antmicro/ddr5-testbed/README.md

# DDR5 Testbed

Copyright (c) 2022-2023 [Antmicro](https://www.antmicro.com)

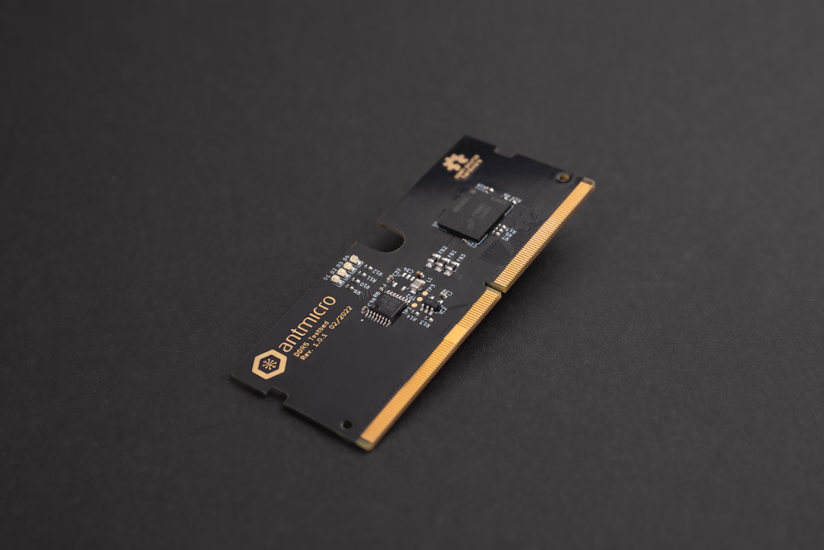
[picture p1: img/ddr5-testbed.png]


## Overview

This project contains open hardware design files for an experimental test module in the mechanical form factor of SO-DIMM.
The module includes a single DDR5 RAM IC with all signals break-routed in the SO-DIMM edge connector.
The board has been designed to target Micron [MT60B2G8HB-48B:A](https://media-www.micron.com/-/media/client/global/documents/products/data-sheet/dram/ddr5/16gb_ddr5_sdram_diereva.pdf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)
16Gb DRAM.
The design files were prepared in KiCad.
Please note that this board is not electrically compatible with off-the-shelf SO-DIMM DDR memory modules.
It is compatible with [this](https://github.com/antmicro/lpddr4-test-board) experimental testing platform.

### Project structure

The main project directory contains KiCad PCB project files, a LICENSE and a README.
The remaining files are stored in the following directories:

* `lib` - contains the component libraries
* `img` - contains graphics for this README
* `doc` - contains schematics in PDF form
* `assets` - contains visual assets for showcasing this design on [Open Hardware Portal](https://openhardware.antmicro.com).

## License

This project is published under the [Apache-2.0](LICENSE) license.
