antmicro/ddr5-testbed/assets/previews/layer0.png

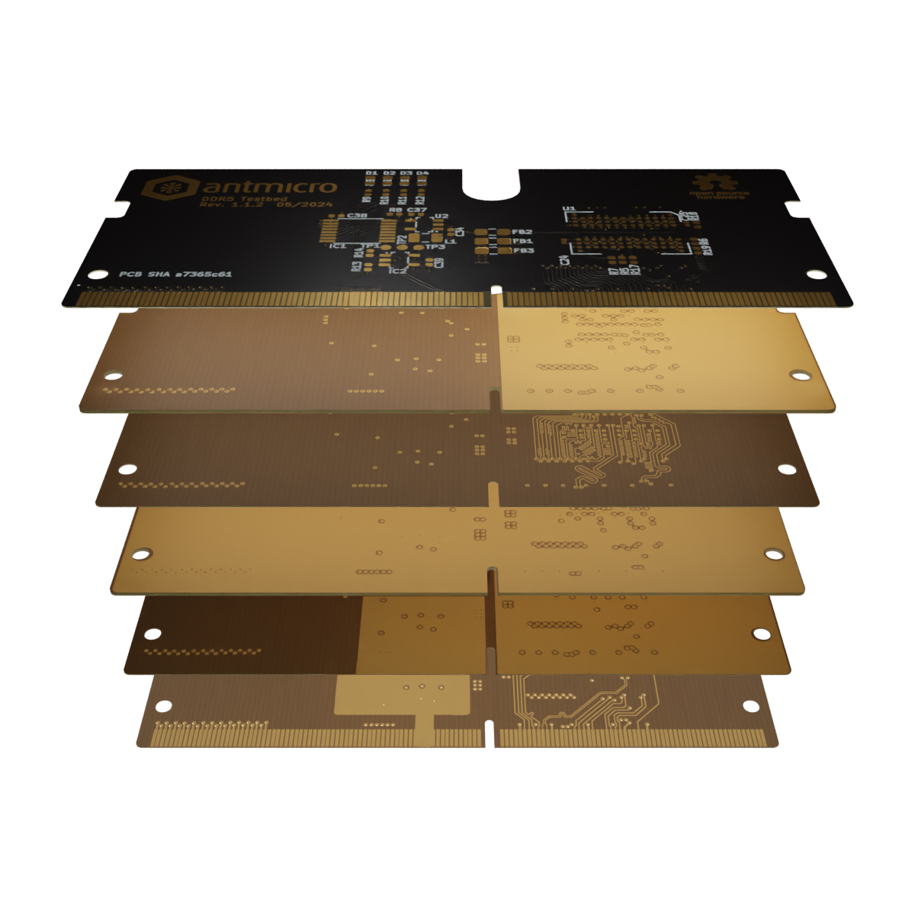
assets/previews/layer0.png
