antmicro/ddr5-testbed/assets/previews/layer3.png

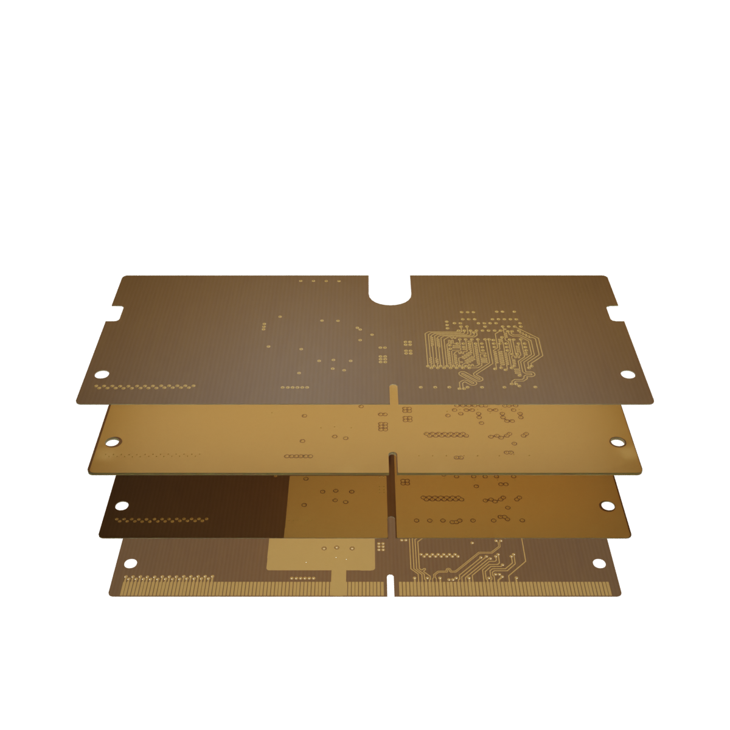
assets/previews/layer3.png
