antmicro/ddr5-testbed/assets/previews/leftT.png

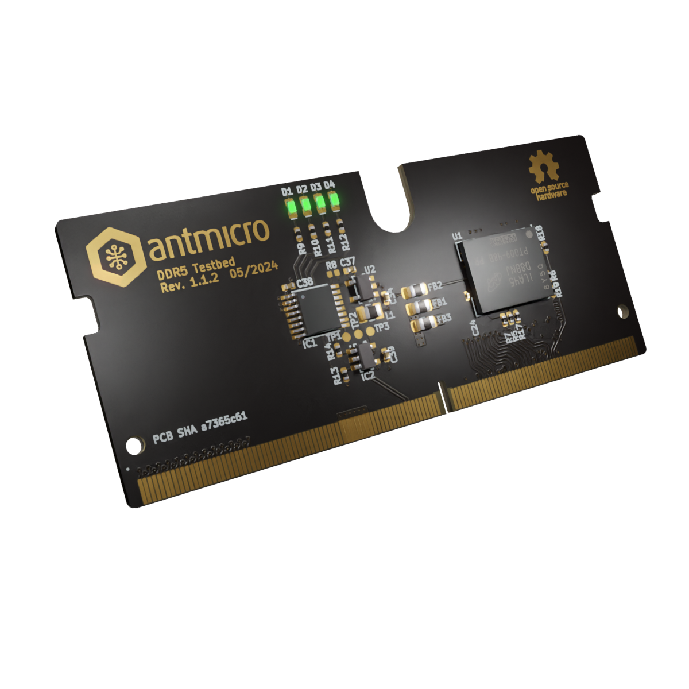
assets/previews/leftT.png
