antmicro/ddr5-testbed/assets/previews/rightT.png

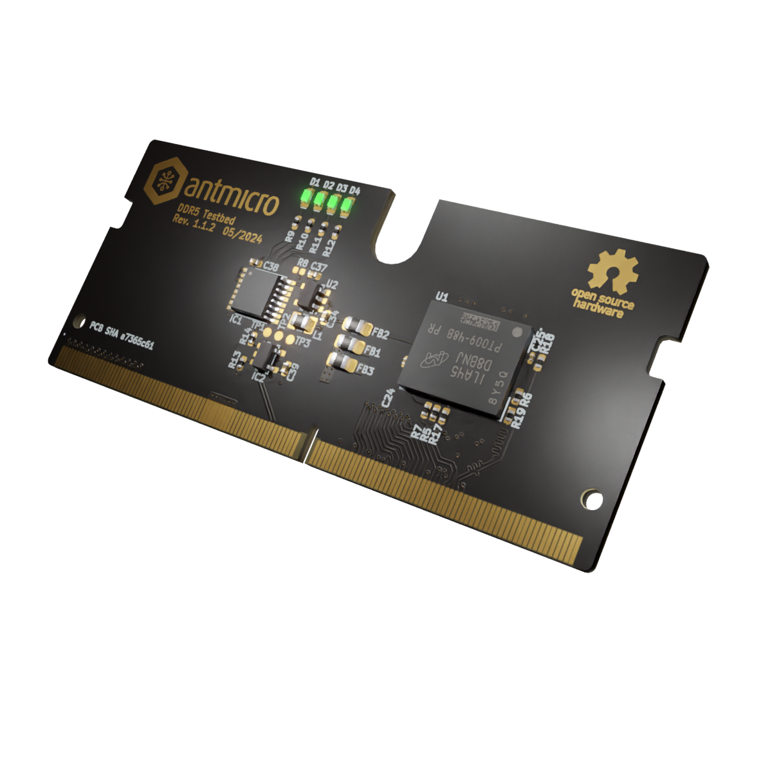
assets/previews/rightT.png
