antmicro/ddr5-testbed/doc/ddr5-testbed.pdf

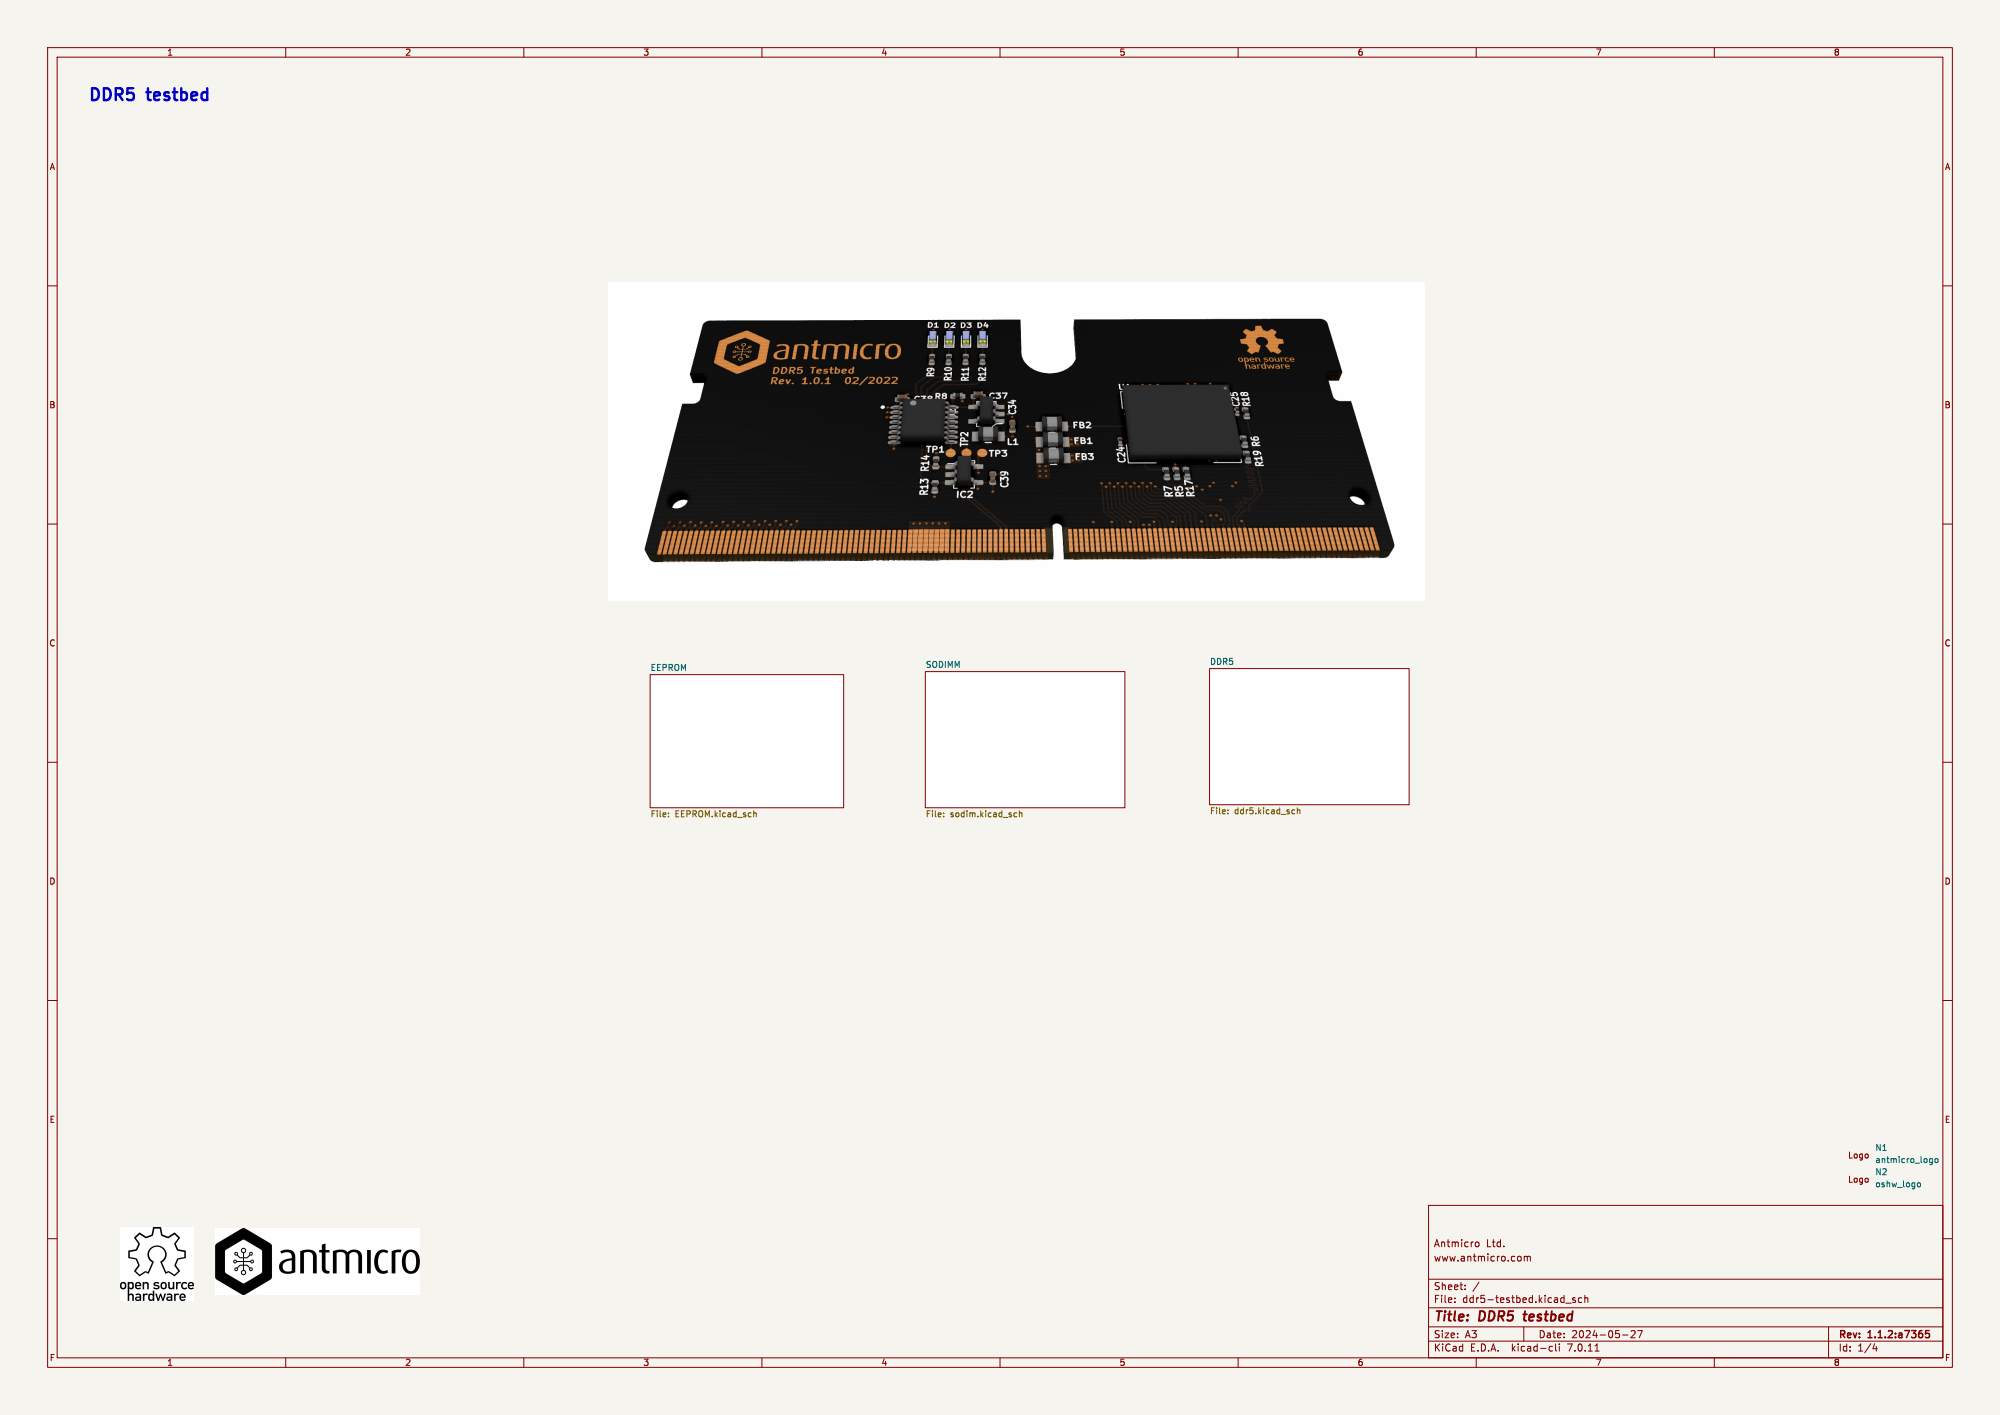
[picture p12: page 1]

File: ddr5-testbed.kicad_sch Sheet: / www.antmicro.com

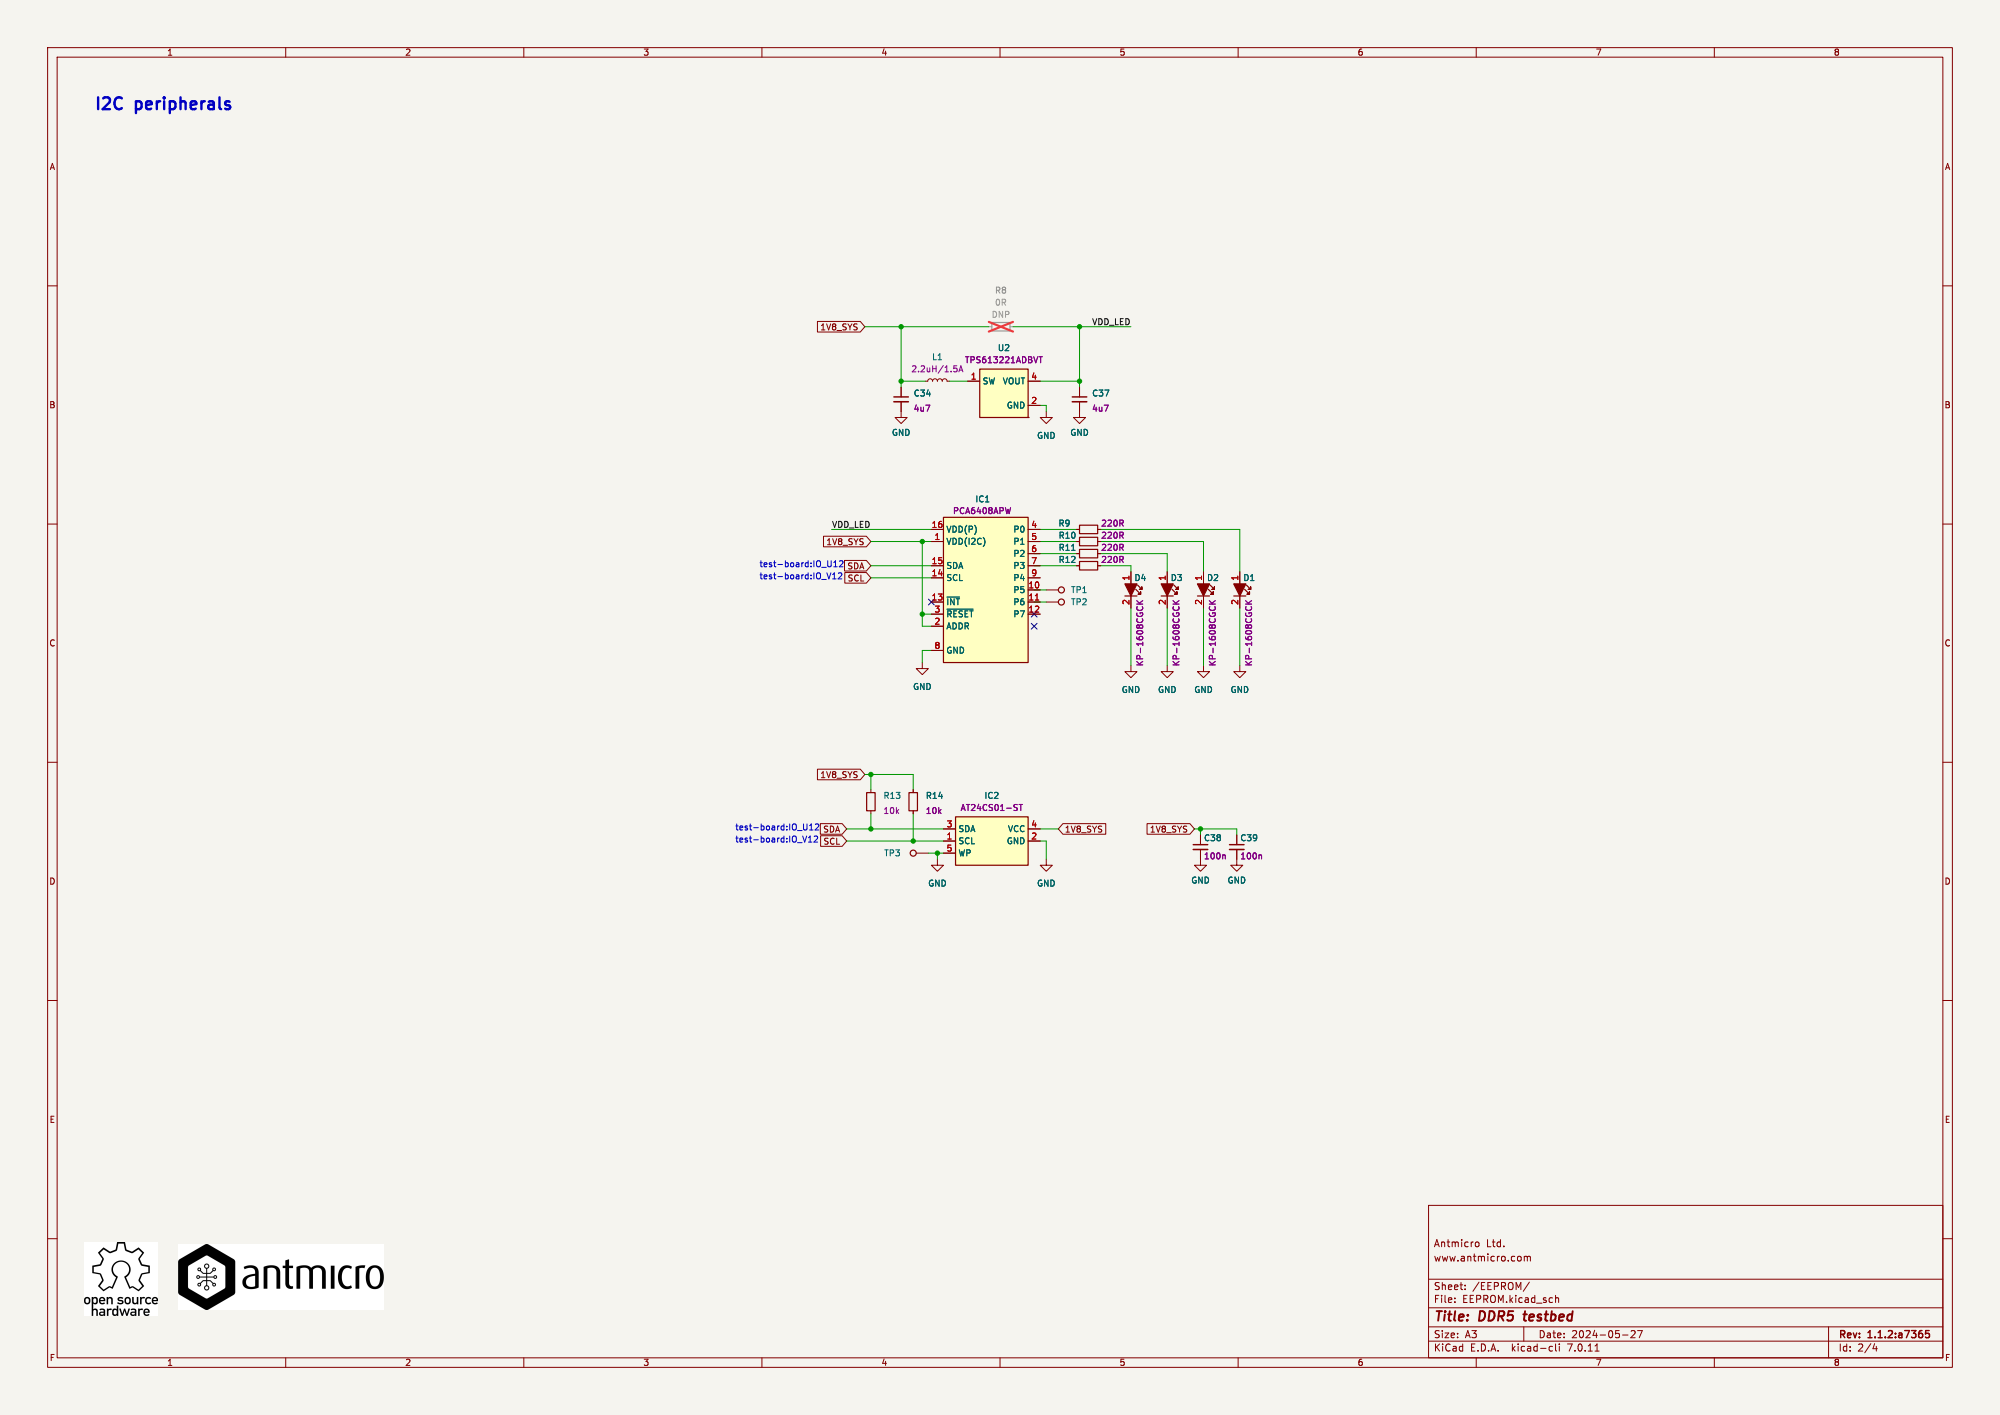
[picture p13: page 2]

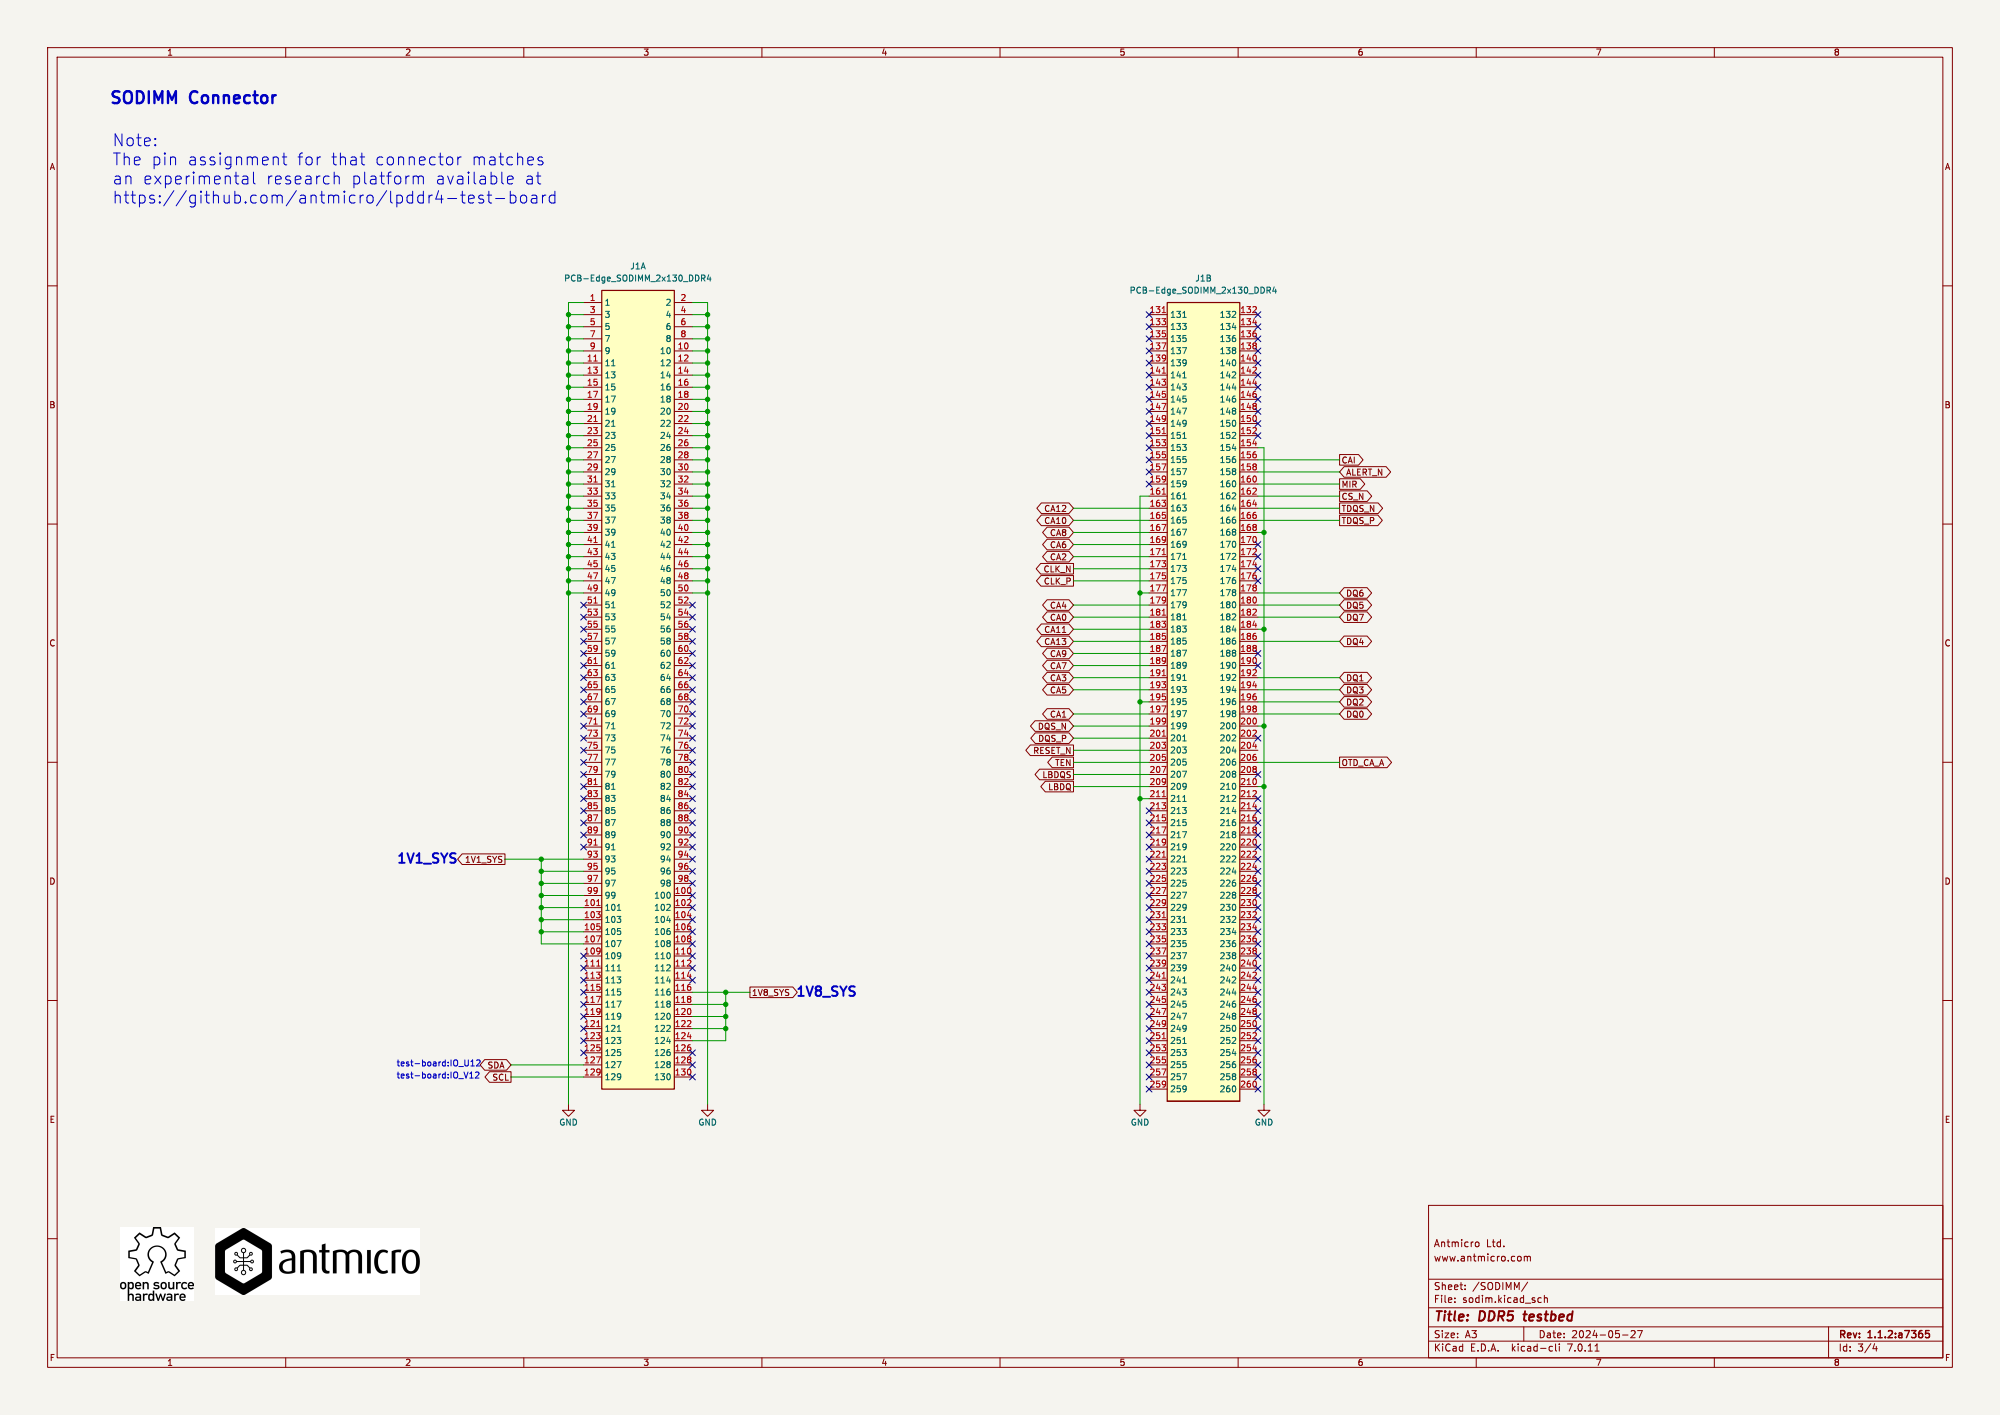
[picture p14: page 3]

Note:
https://github.com/antmicro/lpddr4-test-board

File: sodim.kicad_sch Sheet: /SODIMM/ www.antmicro.com

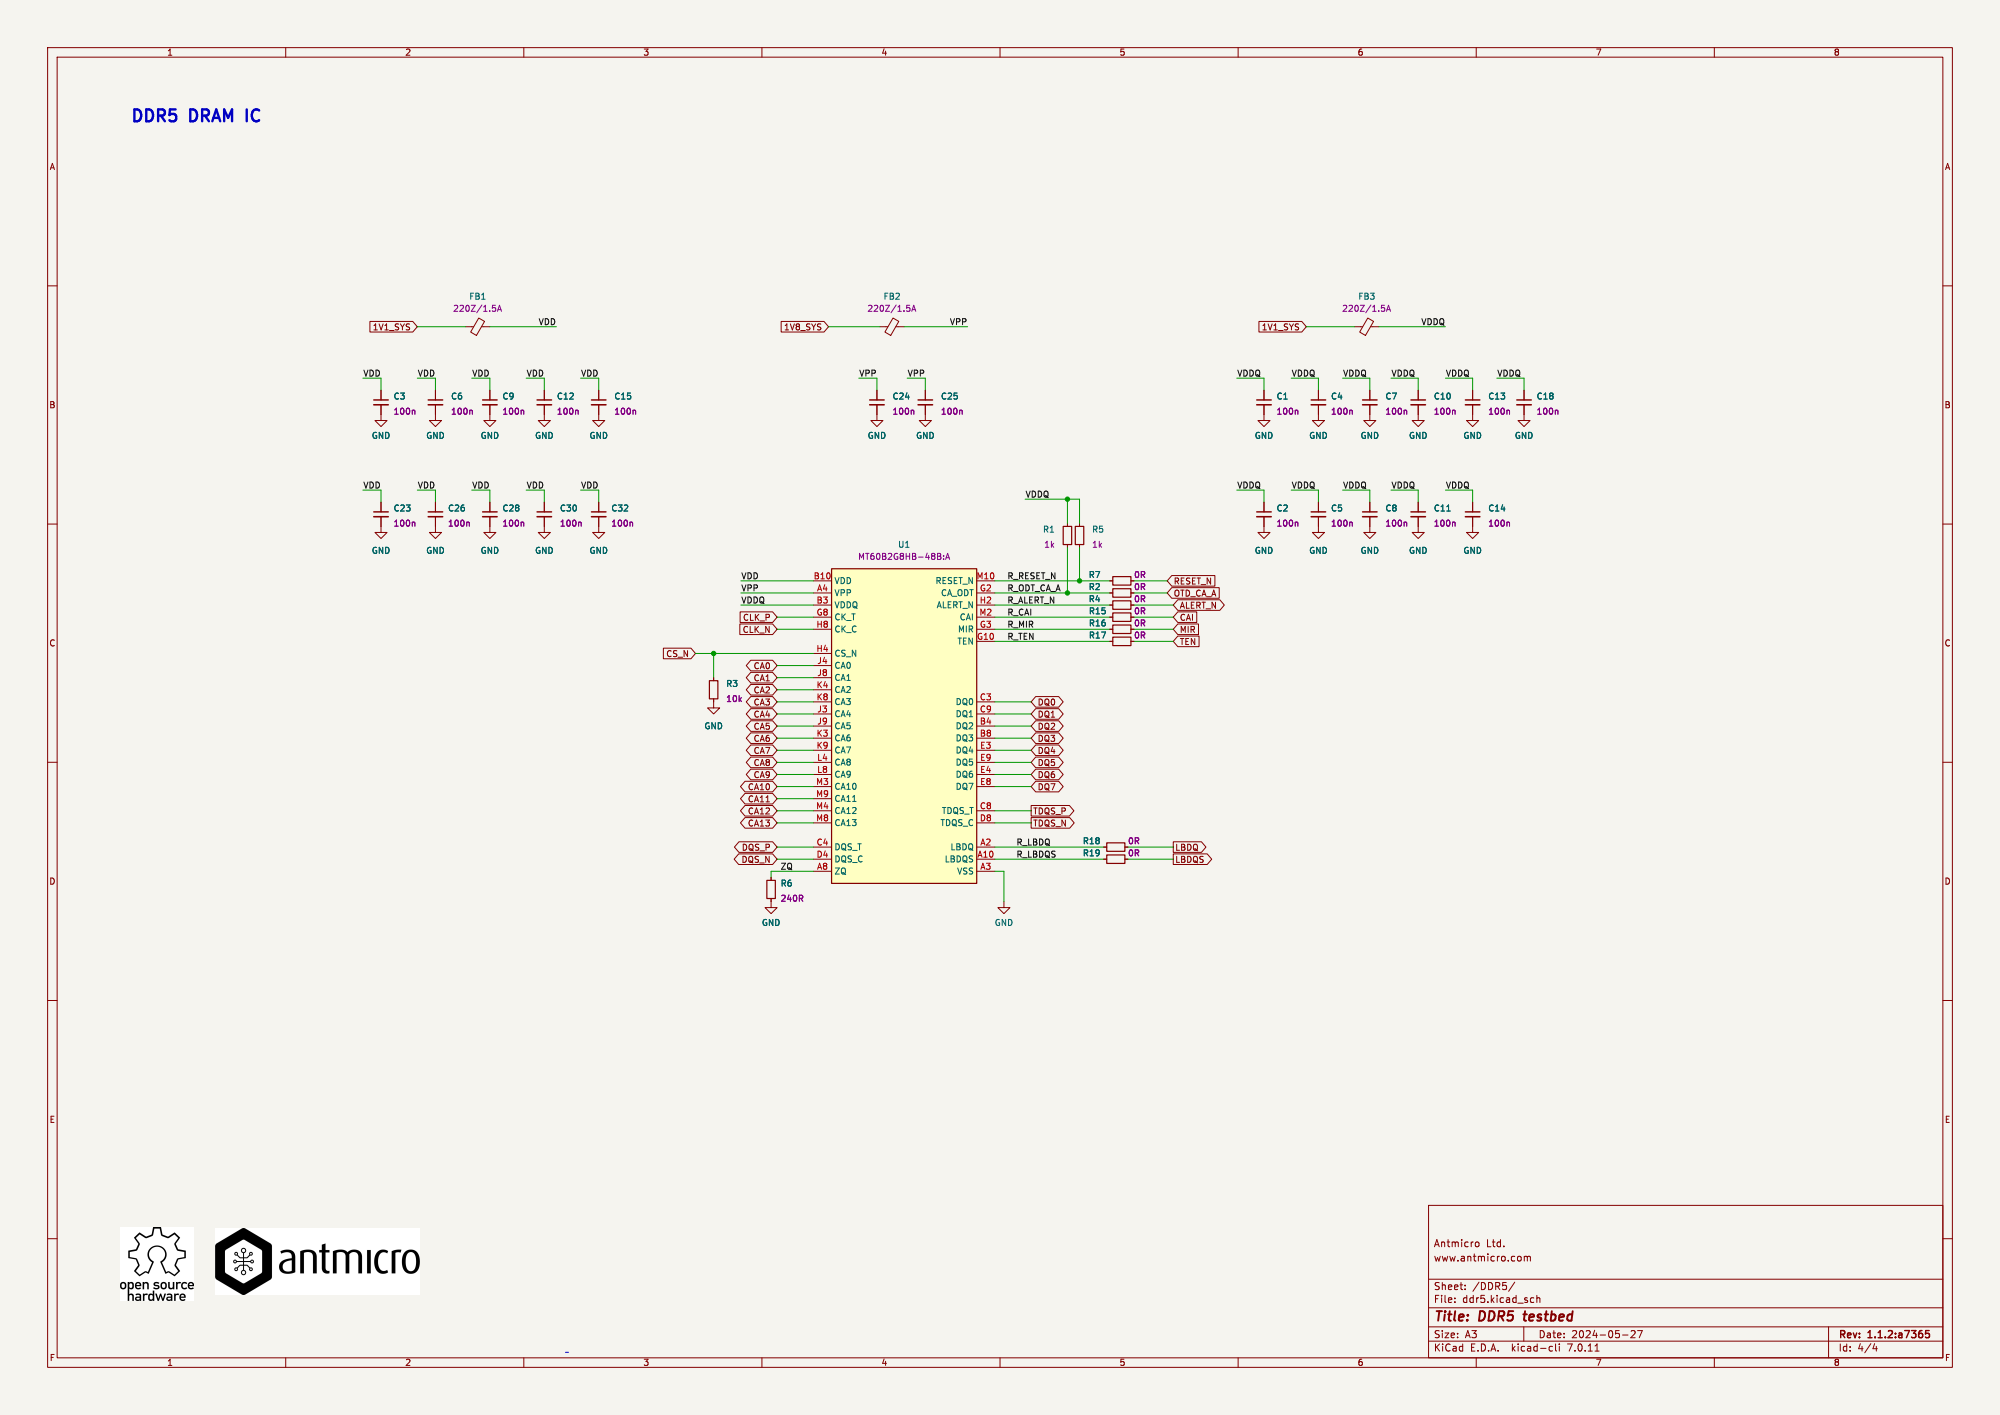
[picture p15: page 4]

File: ddr5.kicad_sch Sheet: /DDR5/ www.antmicro.com
