antmicro/ddr5-testbed/ddr5-testbed.kicad_pcb

## KiCad design ddr5-testbed.kicad_pcb (2023-10-13)

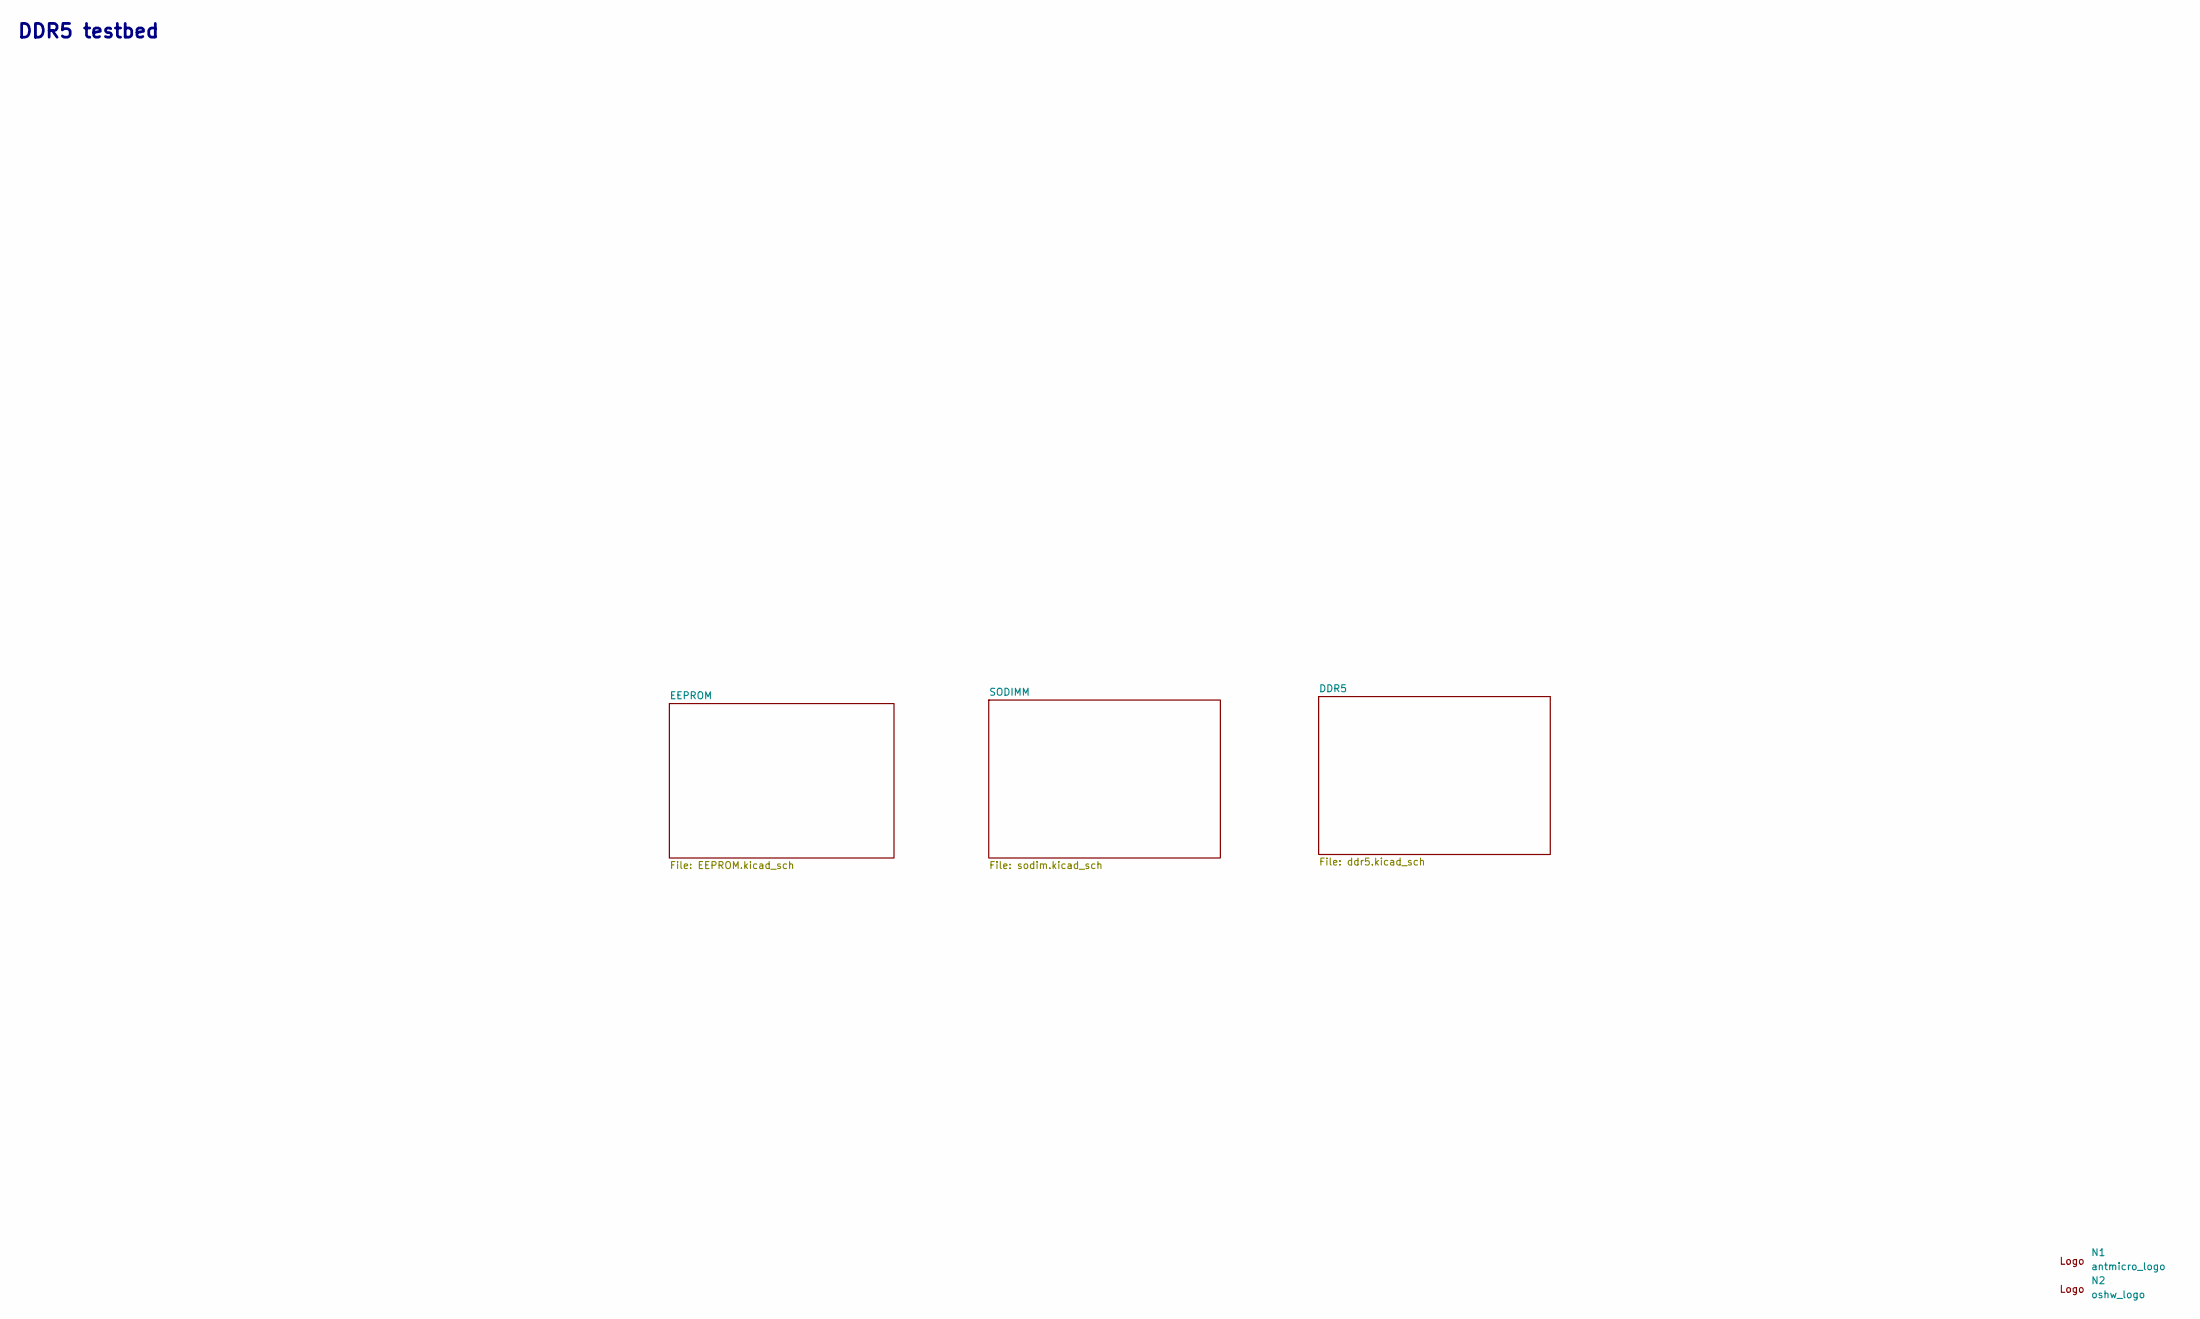
[picture p16: schematic ddr5-testbed.kicad_sch, DDR5 testbed]

Parts:
N1: antmicro_logo; antmicro-logo_scaled_20mm
N2: oshw_logo; oshw-logo

Notes on the sheet:
DDR5 testbed

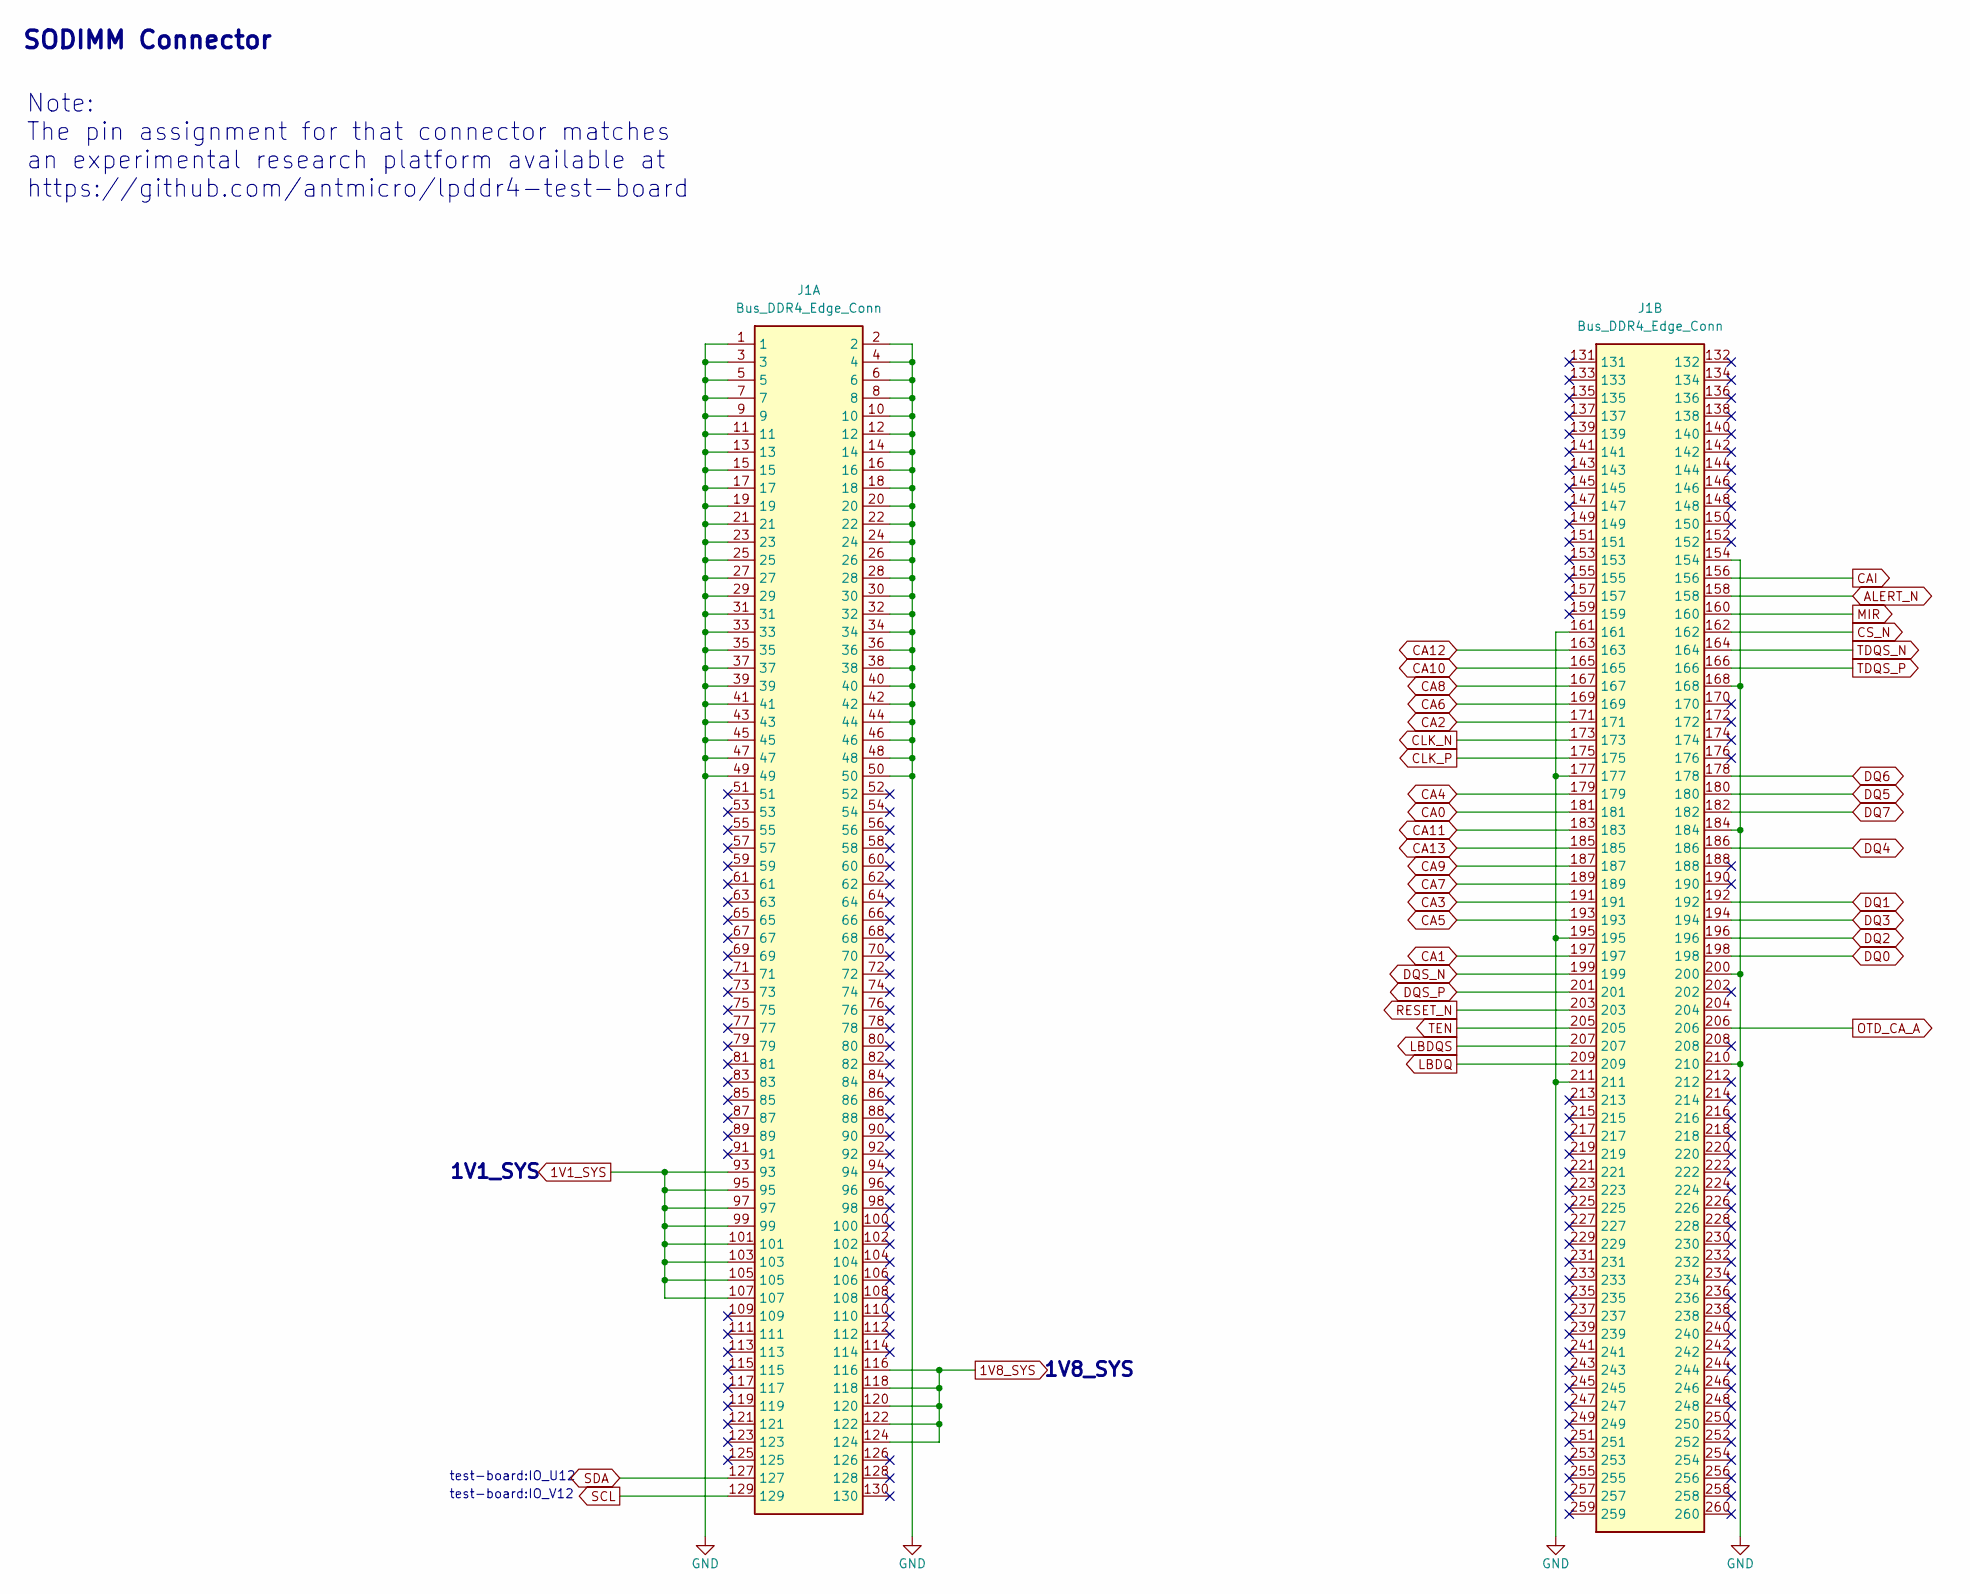
[picture p17: schematic sodim.kicad_sch, DDR5 testbed]

Parts:
J1: Bus_DDR4_Edge_Conn; Bus_DDR4_Conn_Edge

Connections:
1V1_SYS: J1.93, J1.95, J1.97, J1.99, J1.101, J1.103, J1.105, J1.107; also elsewhere on the board
1V8_SYS: J1.116, J1.118, J1.120, J1.122, J1.124; also elsewhere on the board
ALERT_N: J1.158; also elsewhere on the board
CA0: J1.181; also elsewhere on the board
CA1: J1.197; also elsewhere on the board
CA2: J1.171; also elsewhere on the board
CA3: J1.191; also elsewhere on the board
CA4: J1.179; also elsewhere on the board
CA5: J1.193; also elsewhere on the board
CA6: J1.169; also elsewhere on the board
CA7: J1.189; also elsewhere on the board
CA8: J1.167; also elsewhere on the board
CA9: J1.187; also elsewhere on the board
CA10: J1.165; also elsewhere on the board
CA11: J1.183; also elsewhere on the board
CA12: J1.163; also elsewhere on the board
CA13: J1.185; also elsewhere on the board
CAI: J1.156; also elsewhere on the board
CLK_N: J1.173; also elsewhere on the board
CLK_P: J1.175; also elsewhere on the board
CS_N: J1.162; also elsewhere on the board
DQ0: J1.198; also elsewhere on the board
DQ1: J1.192; also elsewhere on the board
DQ2: J1.196; also elsewhere on the board
DQ3: J1.194; also elsewhere on the board
DQ4: J1.186; also elsewhere on the board
DQ5: J1.180; also elsewhere on the board
DQ6: J1.178; also elsewhere on the board
DQ7: J1.182; also elsewhere on the board
DQS_N: J1.199; also elsewhere on the board
DQS_P: J1.201; also elsewhere on the board
GND: J1.1, J1.2, J1.3, J1.4, J1.5, J1.6, J1.7, J1.8, J1.9, J1.10, J1.11, J1.12, J1.13, J1.14, J1.15, J1.16, J1.17, J1.18, J1.19, J1.20, J1.21, J1.22, J1.23, J1.24, J1.25, J1.26, J1.27, J1.28, J1.29, J1.30, J1.31, J1.32, J1.33, J1.34, J1.35, J1.36, J1.37, J1.38, J1.39, J1.40, J1.41, J1.42, J1.43, J1.44, J1.45, J1.46, J1.47, J1.48, J1.49, J1.50, J1.154, J1.161, J1.168, J1.177, J1.184, J1.195, J1.200, J1.210, J1.211; also elsewhere on the board
LBDQ: J1.209; also elsewhere on the board
LBDQS: J1.207; also elsewhere on the board
MIR: J1.160; also elsewhere on the board
OTD_CA_A: J1.206; also elsewhere on the board
RESET_N: J1.203; also elsewhere on the board
SCL: J1.129; also elsewhere on the board
SDA: J1.127; also elsewhere on the board
TDQS_N: J1.164; also elsewhere on the board
TDQS_P: J1.166; also elsewhere on the board
TEN: J1.205; also elsewhere on the board

Notes on the sheet:
1V1_SYS
test-board:IO_V12
Note: The pin assignment for that connector matches an experimental research platform available at https://github.com/antmicro/lpddr4-test-board
SODIMM Connector
1V8_SYS
test-board:IO_U12

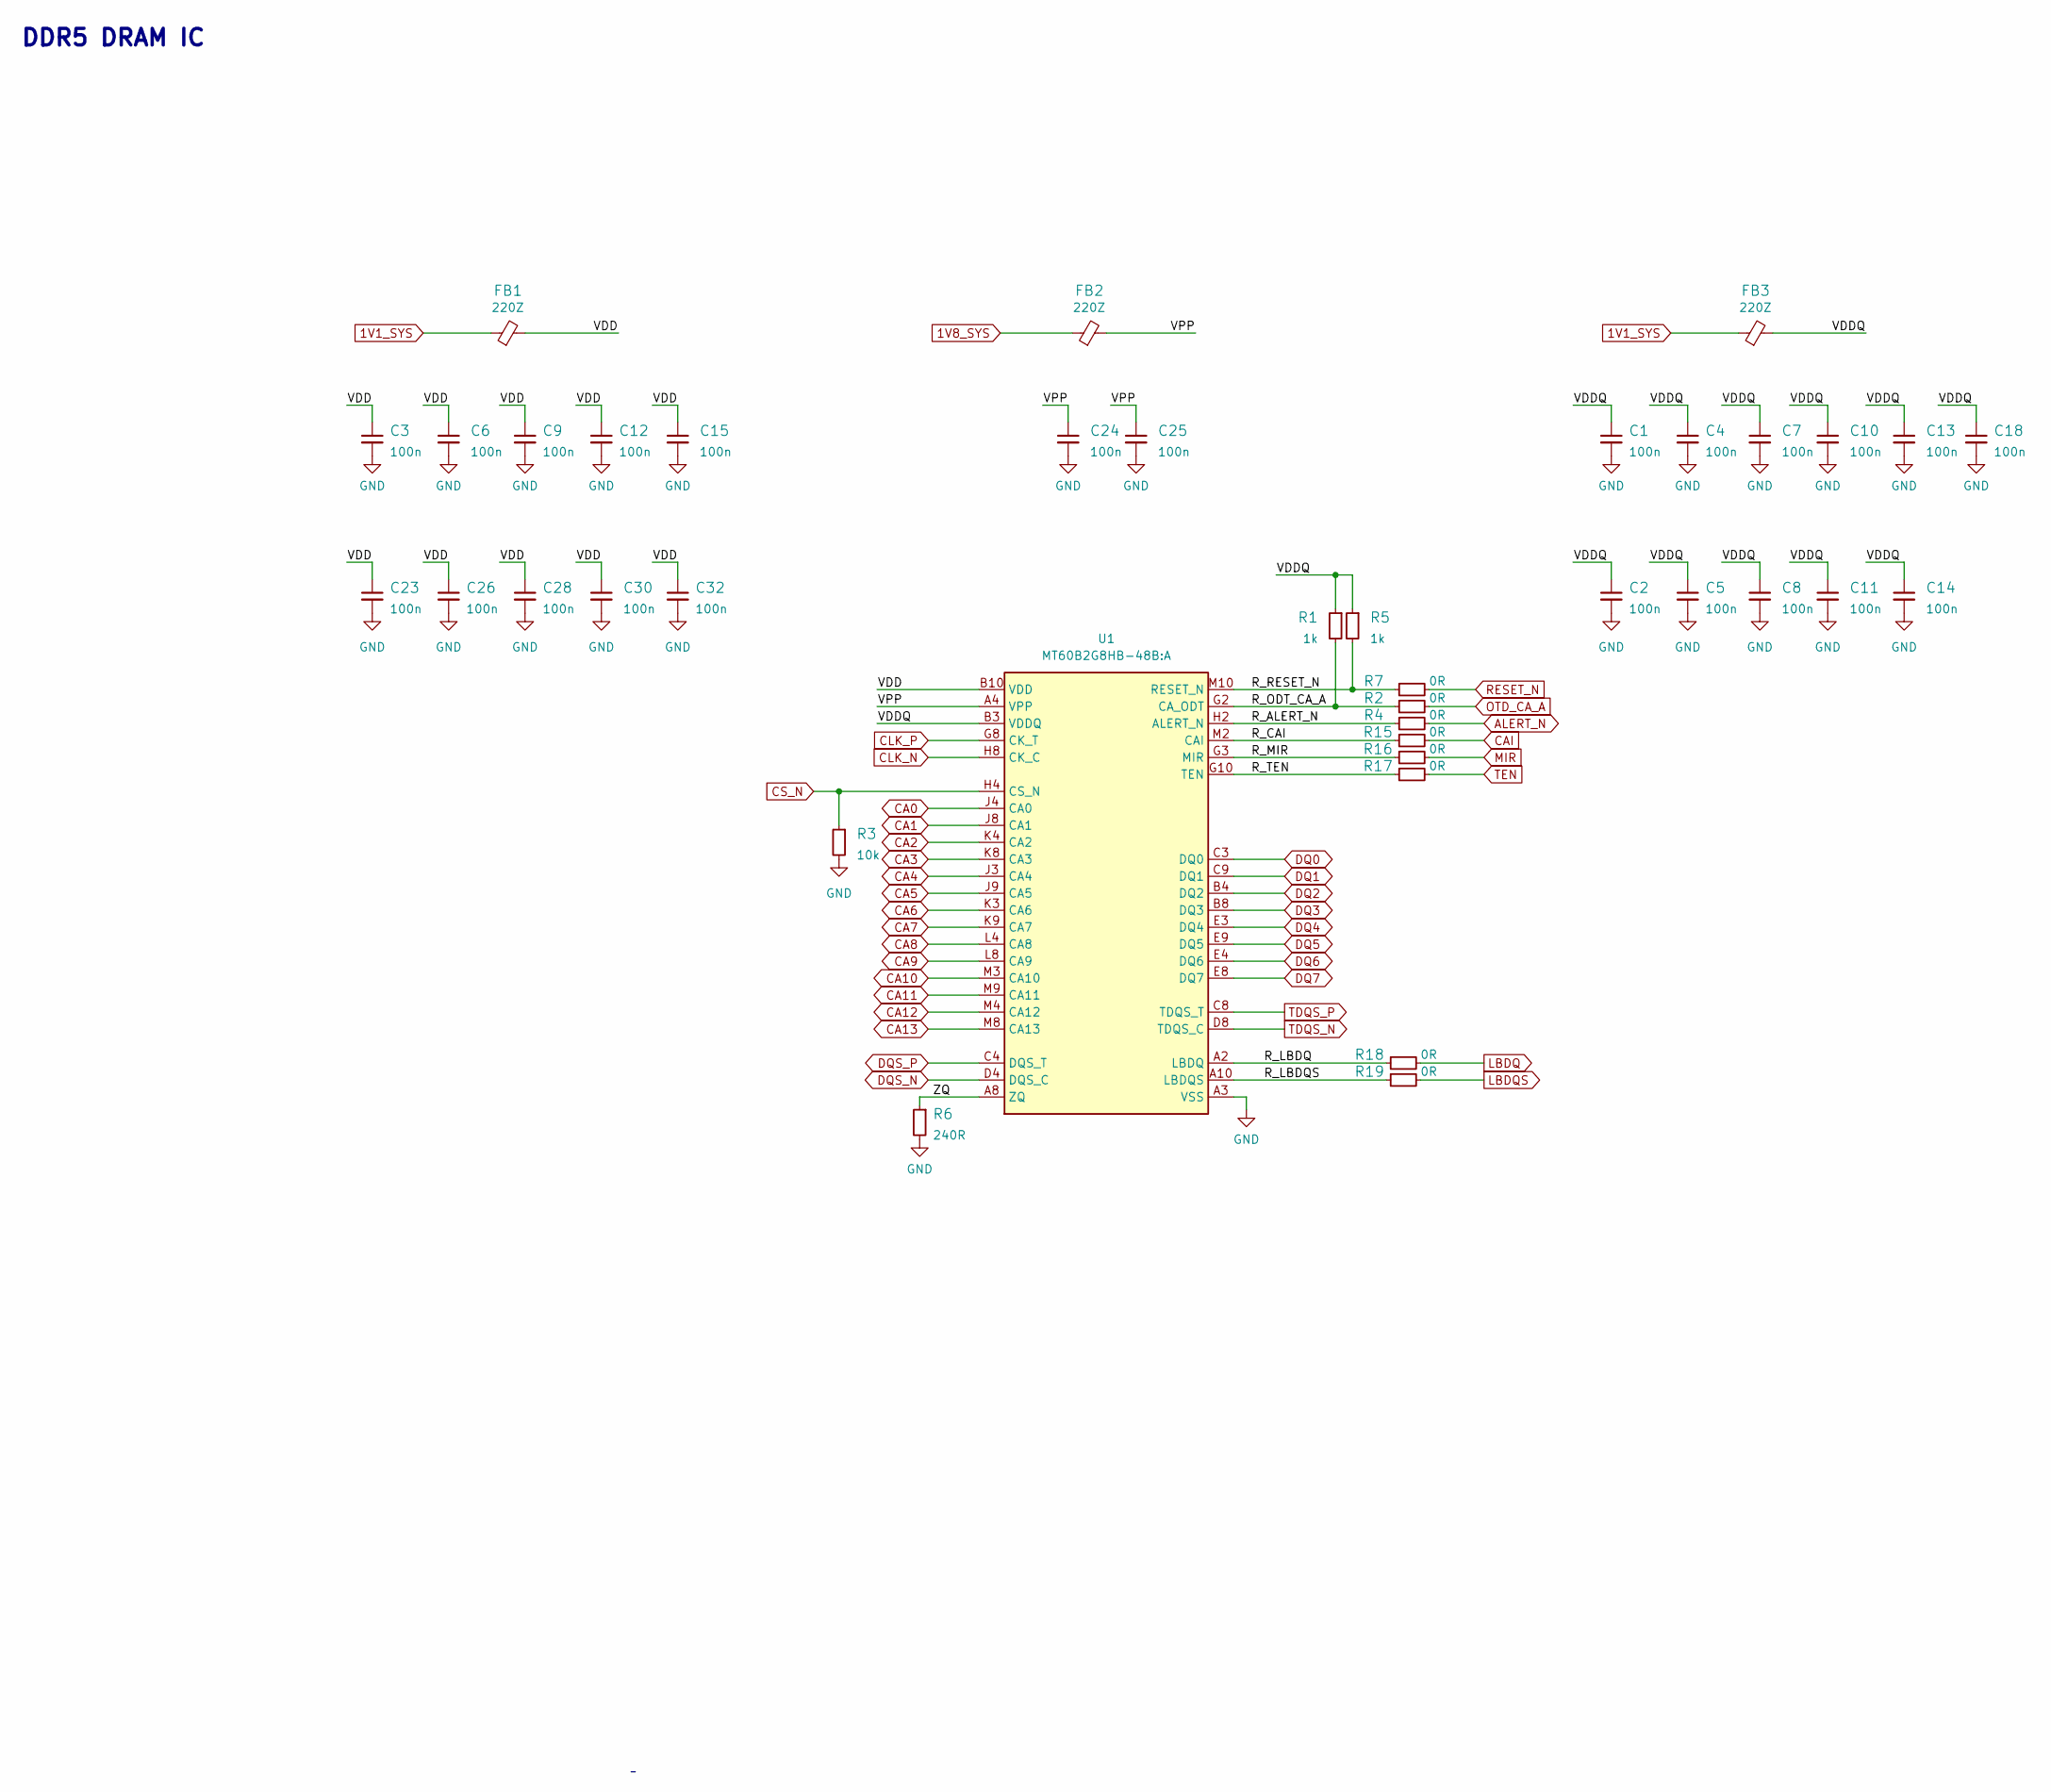
[picture p18: schematic ddr5.kicad_sch, DDR5 testbed]

Parts:
C1, C2, C3, C4, C5, C6, C7, C8, C9, C10, C11, C12, C13, C14, C15, C18, C23, C24, C25, C26, C28, C30, C32: C_100n_0201; C_0201; MPN CC0201KRX6S5BB104
FB1, FB2, FB3: FB_220Z_1.5A_0805; FB_0805_2012Metric; MPN 742792022
R1, R5: R_1k_0402; R_0402_1005Metric; Tolerance 1%; MPN CR0402-FX-1001GLF
R2, R4, R7, R15, R16, R17, R18, R19: R_0R_0402; R_0402_1005Metric; MPN ERJ2GE0R00X
R3: R_10k_0402; R_0402_1005Metric; Tolerance 1%; MPN CR0402-FX-1002GLF
R6: R_240R_0402; R_0402_1005Metric; Tolerance 1%; MPN CR0402-FX-2400GLF
U1: MT60B2G8HB-48B_A; BGA-82_11x9mm_Layout13x11_P0.8mm_DDR5_MO-210-AN; MPN MT60B2G8HB-48B:A

Connections:
1V1_SYS: FB1.1, FB3.1; also elsewhere on the board
1V8_SYS: FB2.1; also elsewhere on the board
/DDR5/R_ALERT_N: R4.1, U1.H2 (ALERT_N)
/DDR5/R_CAI: R15.1, U1.M2 (CAI)
/DDR5/R_LBDQ: R18.1, U1.A2 (LBDQ)
/DDR5/R_LBDQS: R19.1, U1.A10 (LBDQS)
/DDR5/R_MIR: R16.1, U1.G3 (MIR)
/DDR5/R_ODT_CA_A: R1.2, R2.1, U1.G2 (CA_ODT)
/DDR5/R_RESET_N: R5.2, R7.1, U1.M10 (RESET_N)
/DDR5/R_TEN: R17.1, U1.G10 (TEN)
/DDR5/ZQ: R6.1, U1.A8 (ZQ)
ALERT_N: R4.2; also elsewhere on the board
CA0: U1.J4 (CA0); also elsewhere on the board
CA1: U1.J8 (CA1); also elsewhere on the board
CA2: U1.K4 (CA2); also elsewhere on the board
CA3: U1.K8 (CA3); also elsewhere on the board
CA4: U1.J3 (CA4); also elsewhere on the board
CA5: U1.J9 (CA5); also elsewhere on the board
CA6: U1.K3 (CA6); also elsewhere on the board
CA7: U1.K9 (CA7); also elsewhere on the board
CA8: U1.L4 (CA8); also elsewhere on the board
CA9: U1.L8 (CA9); also elsewhere on the board
CA10: U1.M3 (CA10); also elsewhere on the board
CA11: U1.M9 (CA11); also elsewhere on the board
CA12: U1.M4 (CA12); also elsewhere on the board
CA13: U1.M8 (CA13); also elsewhere on the board
CAI: R15.2; also elsewhere on the board
CLK_N: U1.H8 (CK_C); also elsewhere on the board
CLK_P: U1.G8 (CK_T); also elsewhere on the board
CS_N: R3.1, U1.H4 (CS_N); also elsewhere on the board
DQ0: U1.C3 (DQ0); also elsewhere on the board
DQ1: U1.C9 (DQ1); also elsewhere on the board
DQ2: U1.B4 (DQ2); also elsewhere on the board
DQ3: U1.B8 (DQ3); also elsewhere on the board
DQ4: U1.E3 (DQ4); also elsewhere on the board
DQ5: U1.E9 (DQ5); also elsewhere on the board
DQ6: U1.E4 (DQ6); also elsewhere on the board
DQ7: U1.E8 (DQ7); also elsewhere on the board
DQS_N: U1.D4 (DQS_C); also elsewhere on the board
DQS_P: U1.C4 (DQS_T); also elsewhere on the board
GND: C1.2, C2.2, C3.2, C4.2, C5.2, C6.2, C7.2, C8.2, C9.2, C10.2, C11.2, C12.2, C13.2, C14.2, C15.2, C18.2, C23.2, C24.2, C25.2, C26.2, C28.2, C30.2, C32.2, R3.2, R6.2, U1.A3 (VSS), U1.A9 (VSS), U1.C2 (VSS), U1.C10 (VSS), U1.D3 (VSS), U1.D9 (VSS), U1.F2 (VSS), U1.F4 (VSS), U1.F8 (VSS), U1.F10 (VSS), U1.H3 (VSS), U1.H9 (VSS), U1.L3 (VSS), U1.L9 (VSS), U1.N3 (VSS), U1.N9 (VSS); also elsewhere on the board
LBDQ: R18.2; also elsewhere on the board
LBDQS: R19.2; also elsewhere on the board
MIR: R16.2; also elsewhere on the board
OTD_CA_A: R2.2; also elsewhere on the board
RESET_N: R7.2; also elsewhere on the board
TDQS_N: U1.D8 (TDQS_C); also elsewhere on the board
TDQS_P: U1.C8 (TDQS_T); also elsewhere on the board
TEN: R17.2; also elsewhere on the board
VDD: C3.1, C6.1, C9.1, C12.1, C15.1, C23.1, C26.1, C28.1, C30.1, C32.1, FB1.2, U1.B2 (VDD), U1.B10 (VDD), U1.E2 (VDD), U1.E10 (VDD), U1.G4 (VDD), U1.H10 (VDD), U1.K2 (VDD), U1.K10 (VDD), U1.N2 (VDD), U1.N4 (VDD), U1.N10 (VDD)
VDDQ: C1.1, C2.1, C4.1, C5.1, C7.1, C8.1, C10.1, C11.1, C13.1, C14.1, C18.1, FB3.2, R1.1, R5.1, U1.B3 (VDDQ), U1.B9 (VDDQ), U1.D2 (VDDQ), U1.D10 (VDDQ), U1.F3 (VDDQ), U1.F9 (VDDQ), U1.G9 (VDDQ), U1.J2 (VDDQ), U1.J10 (VDDQ), U1.L2 (VDDQ), U1.L10 (VDDQ)
VPP: C24.1, C25.1, FB2.2, U1.A4 (VPP), U1.N8 (VPP)

Notes on the sheet:
DDR5 DRAM IC

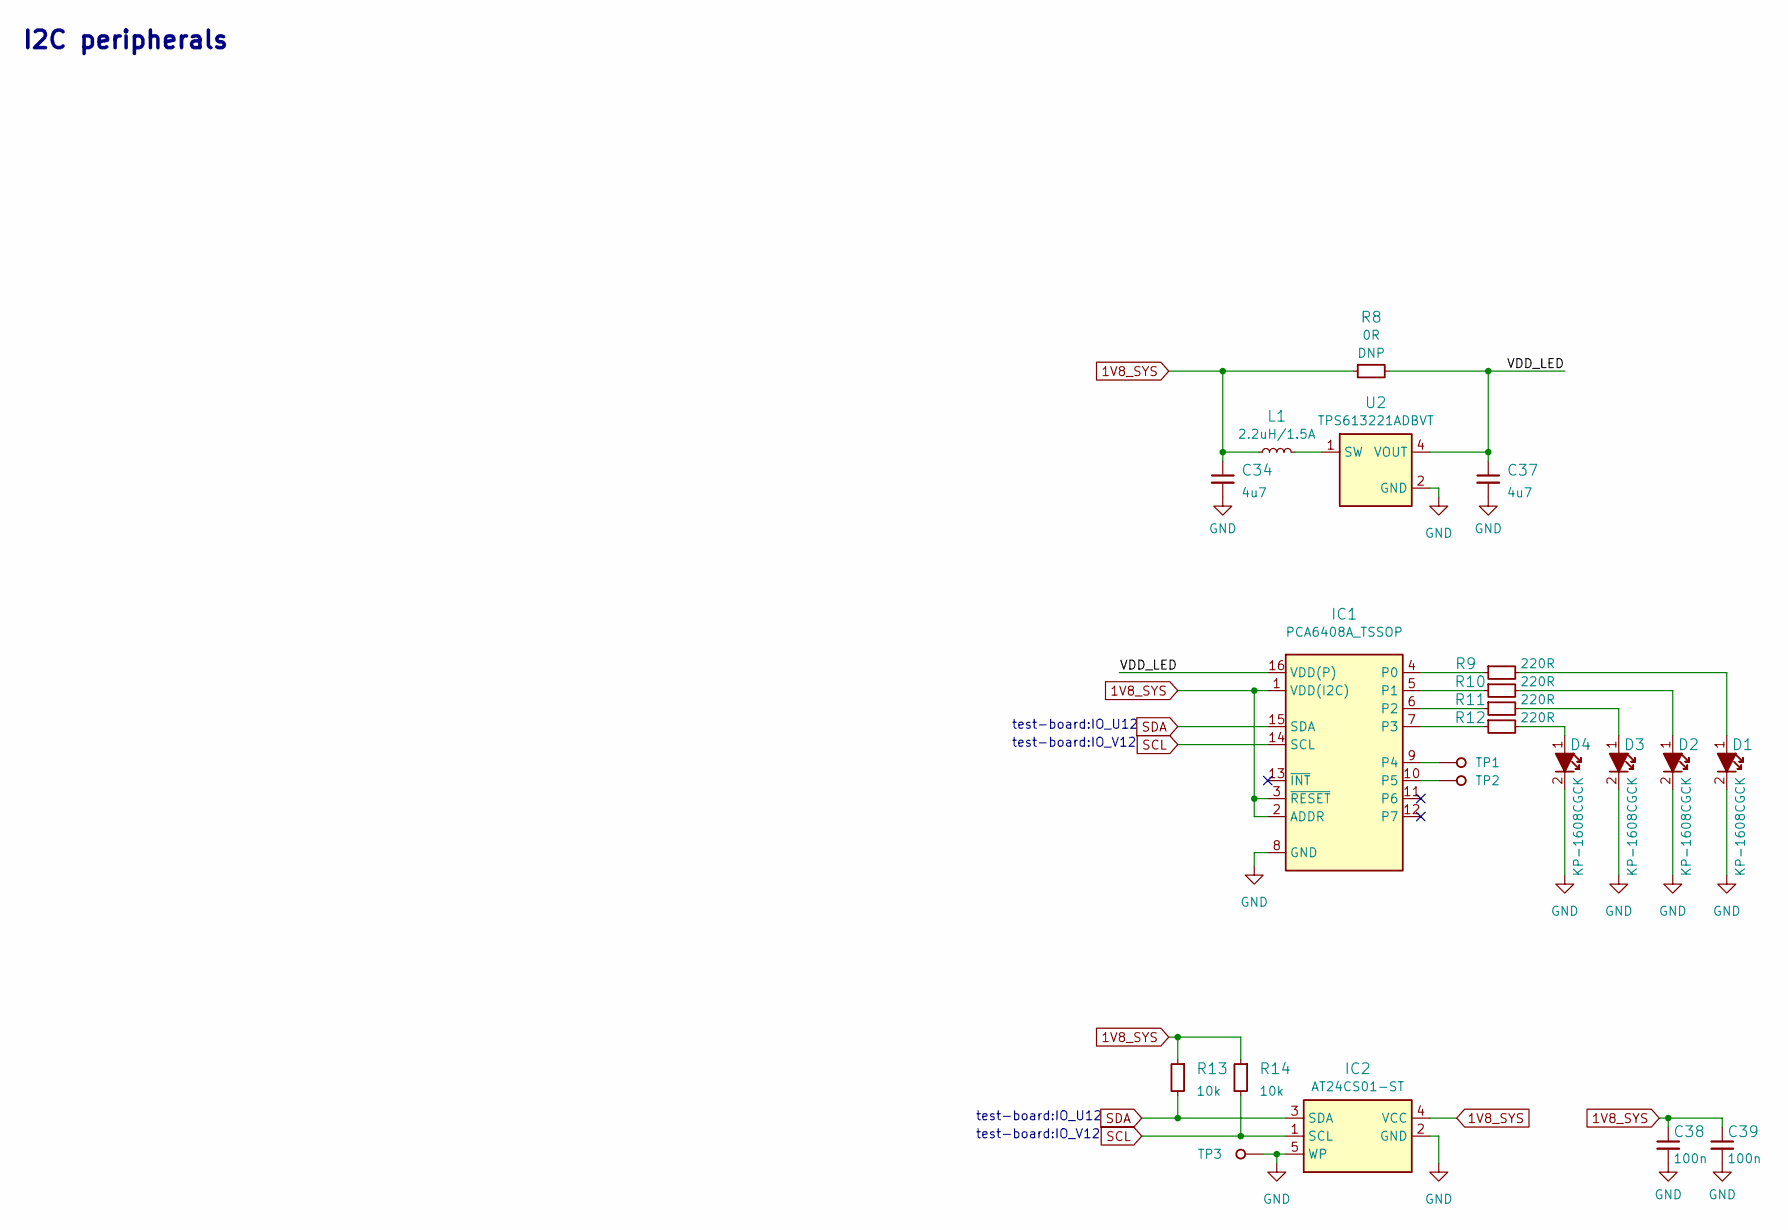
[picture p19: schematic EEPROM.kicad_sch, DDR5 testbed]

Parts:
C34, C37: C_4u7_0402; C_0402_1005Metric; MPN GRM155R61A475MEAAD
C38, C39: C_100n_0402; C_0402_1005Metric; Voltage 50V; MPN GRM155R61H104KE14D
D1, D2, D3, D4: LED_G_0603_KP-1608CGCK; LED_0603_1608Metric_G; MPN KP-1608CGCK
IC1: PCA6408A_TSSOP; TSSOP-16_4.4x5mm_P0.65mm; MPN PCA6408APW
IC2: AT24CS01_SOT23; SOT-23-5; MPN AT24CS01-ST
L1: L_2.2u_1.5A_0806; L_0806_2016Metric; MPN 1285AS-H-2R2M=P2
R8: R_0R_0402; R_0402_1005Metric; MPN ERJ2GE0R00X
R9, R10, R11, R12: R_220R_0402; R_0402_1005Metric; Tolerance 1%; MPN CR0402-FX-2200GLF
R13, R14: R_10k_0402; R_0402_1005Metric; Tolerance 1%; MPN CR0402-FX-1002GLF
TP1, TP2, TP3: TP_1mm_SMD; Testpoint_smd_1mm
U2: TPS613221A_SOT-23-5; SOT-23-5; MPN TPS613221ADBVT

Connections:
1V8_SYS: C34.1, C38.1, C39.1, IC1.1 (VDD(I2C)), IC1.2 (ADDR), IC1.3 (~RESET), IC2.4 (VCC), L1.1, R8.1, R13.1, R14.1; also elsewhere on the board
/EEPROM/VDD_LED: C37.1, IC1.16 (VDD(P)), R8.2, U2.4 (VOUT)
GND: C34.2, C37.2, C38.2, C39.2, D1.2, D2.2, D3.2, D4.2, IC1.8 (GND), IC2.2 (GND), IC2.5 (WP), TP3.1, U2.2 (GND); also elsewhere on the board
unnamed: D1.1, R9.2
unnamed: D2.1, R10.2
unnamed: D3.1, R11.2
unnamed: D4.1, R12.2
unnamed: IC1.4 (P0), R9.1
unnamed: IC1.5 (P1), R10.1
unnamed: IC1.6 (P2), R11.1
unnamed: IC1.7 (P3), R12.1
unnamed: IC1.9 (P4), TP1.1
unnamed: IC1.10 (P5), TP2.1
unnamed: L1.2, U2.1 (SW)
SCL: IC1.14 (SCL), IC2.1 (SCL), R14.2; also elsewhere on the board
SDA: IC1.15 (SDA), IC2.3 (SDA), R13.2; also elsewhere on the board

Notes on the sheet:
I2C peripherals
test-board:IO_U12
test-board:IO_V12

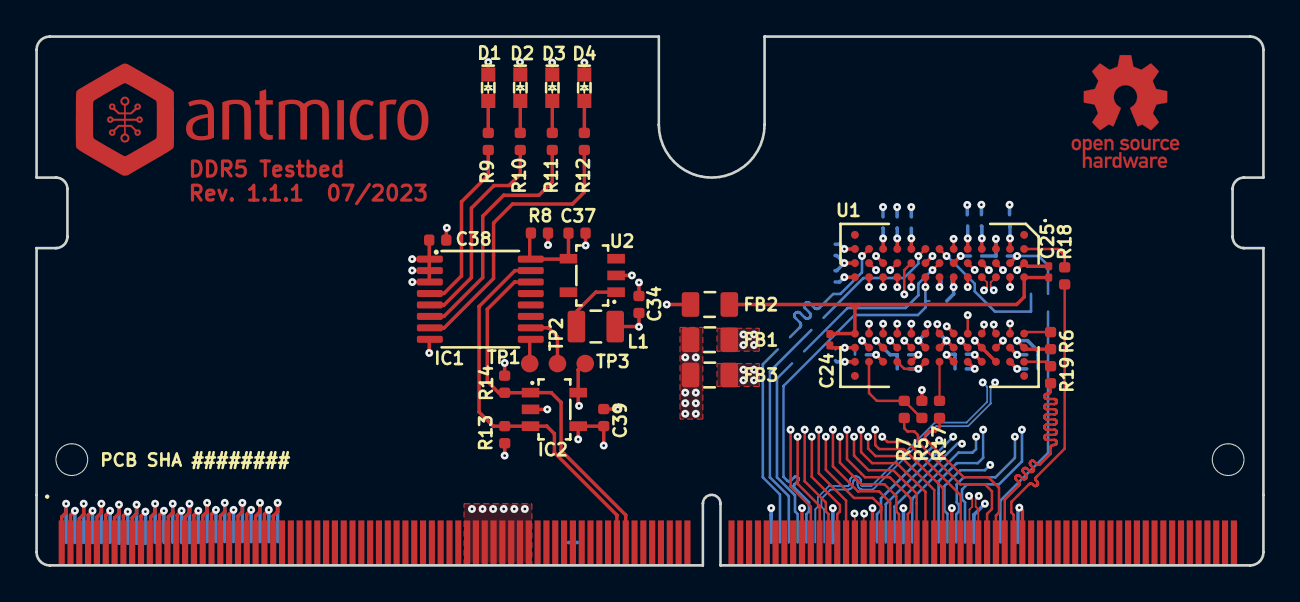
[picture p20: board ddr5-testbed.kicad_pcb from above]

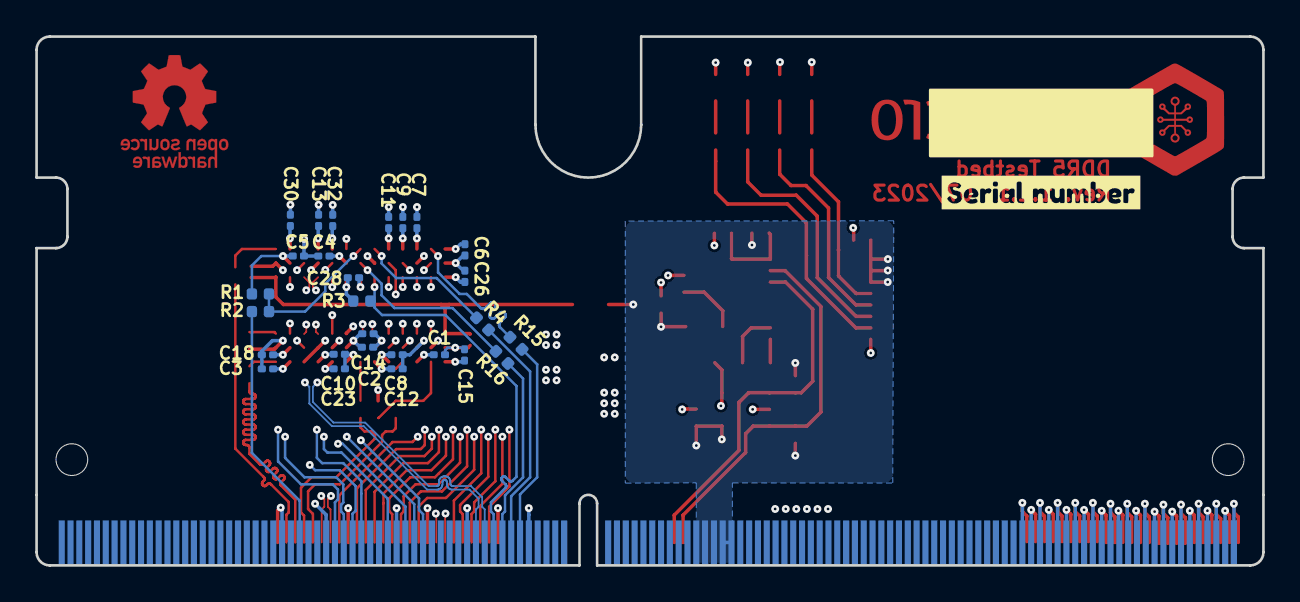
[picture p21: board ddr5-testbed.kicad_pcb from below]

Board: 6 copper layers, 69.6 x 30.0 mm, 65 parts (28 on the bottom side), 66 nets.

Other parts of the board:
kibuzzard-623AE55E: G***; label
