antmicro/ddr5-testbed/(commit log)

2022-03-02 Add logtypes to schematics
    [EEPROM.sch, ddr5-testbed.sch, ddr5.sch, sodim.sch]
2022-03-02 Add no connection flags to unused pins of IC1
    [EEPROM.sch]
2022-03-08 Reduce number of capacitors to match supply pin count, add OR resistors for control signals
    [ddr5.sch]
2022-03-08 Fix power labels naming scheme, remove connection from SODIM to VDDQ, add chockes to DDR5 power
    [EEPROM.sch, ddr5-testbed.kicad_pcb, ddr5.sch, sodim.sch]
2022-03-08 Update silks default values, update project name on PCB
    [ddr5-testbed.kicad_pcb]
2022-03-08 Update project name on schematic
    [ddr5-testbed.sch]
2022-03-08 Update project name and revision on schematics
    [EEPROM.sch, ddr5-testbed.sch, ddr5.sch, sodim.sch]
2022-03-08 Add 0R resistors to LBDQ signals
    [ddr5.sch]
2022-03-08 Update pin assignment
    [sodim.sch]
2022-03-08 Update net classes to match impedance, import changes from sch, add dummy 3D model of DDR5 IC
    [ddr5-testbed.kicad_pcb]
2022-03-08 Update signal assignment
    [sodim.sch]
2022-03-08 Remap connections
    [ddr5-testbed.kicad_pcb]
2022-03-08 Move CAI, ALERT_N, MIR and CA_ODT to other pins of SODIMM
    [sodim.sch]
2022-03-08 Finish SODIMM connections
    [ddr5-testbed.kicad_pcb]
2022-03-08 Resize schematic sheet
    [EEPROM.sch]
2022-03-08 Add signal labels to SCH
    [ddr5.sch]
2022-03-08 Update SODIMM signal assignment
    [sodim.sch]
2022-03-08 Tune DQ traces
    [ddr5-testbed.kicad_pcb]
2022-03-08 Tune CA traces
    [ddr5-testbed.kicad_pcb]
2022-03-08 Tune LBDQ traces
    [ddr5-testbed.kicad_pcb]
2022-03-08 Silks cleanup, fix date text
    [ddr5-testbed.kicad_pcb]
2022-03-08 Change pullup resistors to 1K
    [ddr5-testbed.kicad_pcb, ddr5.sch]
2022-03-08 Change R6 to 1% tolerance
    [ddr5-testbed.kicad_pcb, ddr5.sch]
2022-03-08 Assign schematic labels
    [EEPROM.sch, ddr5-testbed.sch, ddr5.sch, sodim.sch]
2022-03-08 Add 3D Vis, fix overlapping references
    [ddr5-testbed.kicad_pcb]
2022-03-08 Add board vis to sch
    [ddr5-testbed.sch]
2022-12-28 Migrate to KiCad 6
    [EEPROM.kicad_sch, EEPROM.sch, ddr5-testbed.kicad_pcb, ddr5-testbed.kicad_sch, ddr5-testbed.sch, ddr5.kicad_sch, ddr5.sch, sodim.kicad_sch]
2022-12-28 Clear DRC
    [ddr5-testbed.kicad_pcb]
2022-12-28 Bump revision to 1.0.2
    [ddr5-testbed.kicad_pcb]
2022-12-29 Update revision on schematic sheets
    [EEPROM.kicad_sch, ddr5-testbed.kicad_sch, ddr5.kicad_sch, sodim.kicad_sch]
2023-01-11 Corrected board stackup and thickness
    [ddr5-testbed.kicad_pcb]
2023-01-11 Added on bottom silkscreen field for serial number
    [ddr5-testbed.kicad_pcb]
2023-01-13 Added PCB SHA string
    [ddr5-testbed.kicad_pcb]
2023-01-13 Bump revision to 1.1.0
    [EEPROM.kicad_sch, ddr5-testbed.kicad_pcb, ddr5-testbed.kicad_sch, ddr5.kicad_sch, sodim.kicad_sch]
2023-06-05 Update PCB marking string
    [ddr5-testbed.kicad_pcb]
2023-10-13 Introduce component standardization
    [EEPROM.kicad_sch, ddr5-testbed.kicad_pcb, ddr5-testbed.kicad_sch, ddr5.kicad_sch, sodim.kicad_sch]
2023-10-16 Add OHP assets
    [stackup.csv]
2023-12-29 Add PDF schematic
2024-05-27 Bump to Kicad7
    [EEPROM.kicad_sch, ddr5-testbed.kicad_sch, ddr5.kicad_sch, sodim.kicad_sch]
2024-05-27 Update edge connector on schematic
    [sodim.kicad_sch]
2024-05-27 Fix broken library references
    [EEPROM.kicad_sch, ddr5-testbed.kicad_sch, ddr5.kicad_sch]
2024-05-27 Update footprints and symbols from library, clear DRC
    [EEPROM.kicad_sch, ddr5-testbed.kicad_sch, ddr5.kicad_sch, sodim.kicad_sch]
2024-06-03 Hide edge connector designator
2024-06-06 Update designators
    [EEPROM.kicad_sch, ddr5.kicad_sch]
2024-06-06 [#60007] Update PDF schematic
